tianqiQWQ/alpa-lens-board-generator/交付说明.md

# 交付说明 · ALPA 镜头板生成器 v4

## 交付物

| 文件 | 说明 |
|---|---|
| **`ALPA镜头板生成器.html`** | **主交付物**：单文件离线网页（726 KiB），双击即用；three.js 已内联，无任何外部请求 |
| `index.html` | GitHub Pages 入口（与主文件同内容） |
| `samples/` | 7 组预设的 STL / 3MF / 参数 TXT + `samples.json` 索引 |
| `preview/` | 12 张截图（方箱等轴/正视/剖视/俯视/仰视/80、⌀35 板、凸台、锥面板、锥形延长、移动端、非法参数） |
| `src/` `vendor/` | 源码（6 个模块）与内联依赖 |
| `tools/` | 打包、几何单测、端到端、静态验收、样例生成、参考件提取 |
| `README.md` | 使用说明 + 几何定义 + 与参考件对比 + 打印建议 |
| `LICENSE` | MIT |

## 本轮新增（v3.1 → v4）

**第二种延长方式：方箱延长**，按 `ALPA猪嘴 130mm延长.step` 复刻：

| 项 | 实测 / 规则 |
|---|---|
| 总长 | **130 = 底板 3 + 方桶 124 + 顶板 3**，可调 10–220 |
| 底板 | ALPA 板轮廓（78/82.5/88.5 × 3 mm），中间方孔 = 内腔 |
| 方桶 | 四面直壁，**外 88.5 方**，内腔 = 88.5 − 2×壁厚（壁厚默认 6.25 → 内 76） |
| 顶板 | 3 mm，中心开孔（圆孔 ⌀D 或内螺纹，默认 M65×1，贯通 3 mm） |
| 外观 | 88.5 方 + 阶梯切角（R3/R6），按参考件复刻 |
| 底板 | ALPA 板层级 78 R4 / 82.5 R5 / 88.5 R8 |
| 桶身 / 顶板 | 88.5 阶梯切角（连续切角） |
| 内壁 | 4 条光陷阱凹台（深 1.25 / 宽 46.7） |
| 体积 | 201,468 mm³（对齐 3MF 参考 201,949.9，−0.24 %） |

形态切换：「单板 / 锥形延长 / 方箱延长」三选一；方箱形态下「开口」卡片自动变成「顶面开口」，凸台卡片隐藏。

## 怎么用

1. 双击 `ALPA镜头板生成器.html`（Chrome / Edge）。
2. 左侧「形态」选 **方箱延长**：
   - 总长（默认 130）
   - 桶壁厚（默认 6.25，下方自动显示内腔尺寸与分段）
   - 「顶面开口」：圆孔 ⌀D 或 内螺纹（M65/M52/M42… 或自定义）
3. 选「单板」：板型 / 凸台 0–5 / 圆孔或内螺纹；选「锥形延长」：延长长度 / 外锥根部 / 顶端螺纹。
4. 右上：等轴 / 正视 / 侧视 / 俯视 / 仰视，可开剖视、标注、线框；`1–5` 是视图快捷键。
5. 底部导出 STL / 3MF / 参数 JSON / 参数 TXT / 截图。

## 验收摘要（本机实测）

| 检查 | 结果 |
|---|---|
| `tools/test-geometry.mjs` | **117 / 117** 通过 |
| `tools/verify-built.mjs` | **23 / 23** 通过 |
| `tools/e2e.mjs` | **85 / 85** 通过（含方箱几何、真实下载、剖视、三个形态切换、零报错） |
| 方箱 | 以 3MF 切面为准：外形、内腔、光陷阱凹台全部对上；体积 201,468 vs 201,950（−0.24 %） |

## 会拦截 / 提示的情况

| 情况 | 行为 |
|---|---|
| 方箱总长 < 10 或 > 220 | 红字拦截 |
| 方箱壁厚 < 2 或 > 20 | 红字拦截 |
| 方箱总长 < 8（底板 3 + 顶板 3 + 桶 2） | 红字拦截 |
| 顶面孔 / 螺纹 > ⌀82.5 | 红字拦截（按 88.5 顶板算） |
| 方箱 > 150 mm | 黄字提示注意刚性 |
| 锥形：外锥太钝 / 内锥超 ⌀77 / 壁厚 < 1.5 | 红字拦截 |
| 单板：凸台壁厚 < 1.2 / 锥面 > 60° | 红字拦截 / 黄字提示 |

## 本轮修正（v4.4）

1. **底板开口固定为 76**（+0.5 浅凹台，取自参考件），调壁厚时只有桶身内腔变化，底板不动。
2. **顶面孔上限改成 ⌀82.5**（顶板外形 88.5，留 3 mm 边），不再用内腔去限制；之前误限到 ⌀62.5–74。

## v4.5 默认值变更

- **默认延长高度全部改为 20 mm**：锥形延长 `extLen=20`（总高 23）；方箱延长 `boxLen=20`（底板 3 + 方桶 14 + 顶板 3）。参考件长度保留为预设（方箱 130、锥形 21.4）。
- 预设表扩到 7 个，`samples/` 随之变为 7 组。
- 三种形态各补一张全景 + 一张截面示例图（合计 14 张）。

## 后续可做

- 方箱的光陷阱台阶、8 条角部纵向孔
- 两件式延长桶（可换螺纹前板）
- 相机侧卡口槽、沉台 / Copal 沉孔
- 真 B-rep STEP 输出（build123d，复用同一套参数 JSON）供 CNC
