tianqiQWQ/alpa-lens-board-generator/samples/ALPA_方箱_M65x1_L20_W6.25mm.3mf

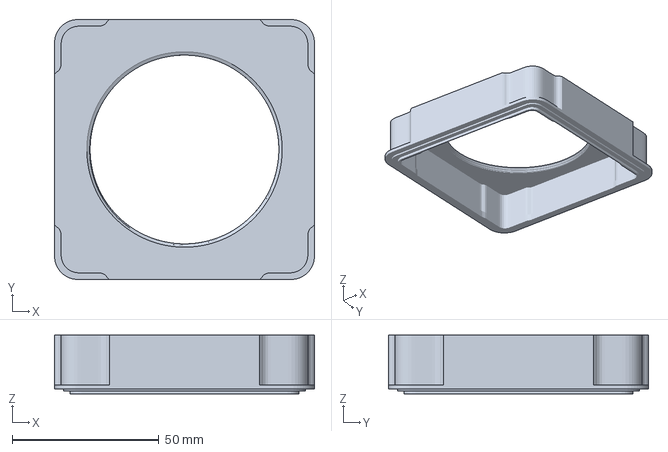
[picture p12: CAD file, 2026-11-07]
samples/ALPA_方箱_M65x1_L20_W6.25mm.3mf
88.5 x 88.5 x 20.0 mm
