tianqiQWQ/alpa-lens-board-generator/samples/ALPA_标准板_D35_H3mm.3mf

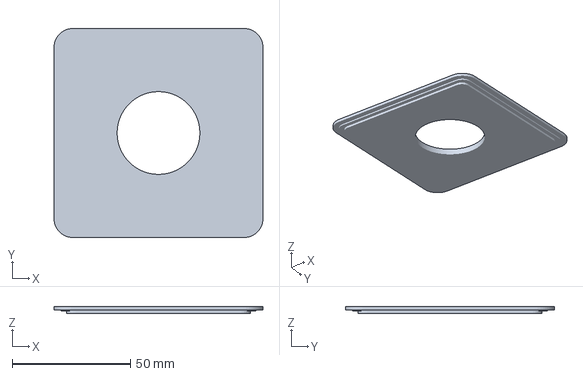
[picture p13: CAD file, 2026-11-07]
samples/ALPA_标准板_D35_H3mm.3mf
88.5 x 88.5 x 3.00 mm
