tianqiQWQ/alpa-lens-board-generator/samples/ALPA_锥面板_M65x1_boss2_H5mm.3mf

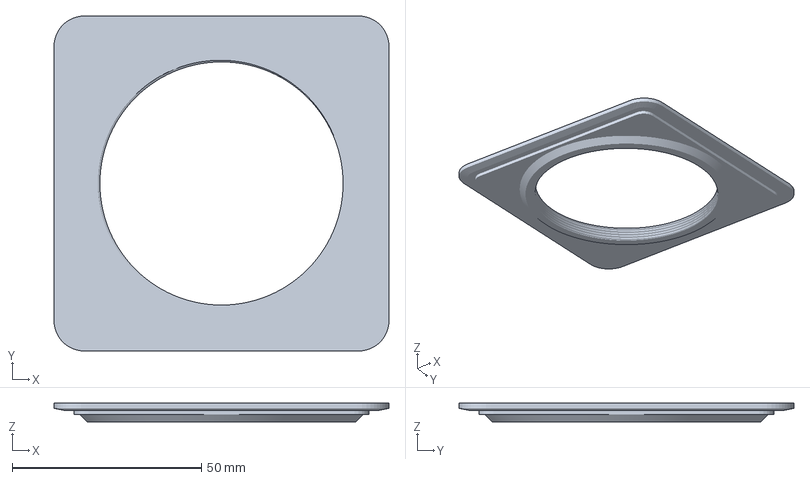
[picture p14: CAD file, 2026-11-07]
samples/ALPA_锥面板_M65x1_boss2_H5mm.3mf
88.5 x 88.5 x 5.00 mm
