tianqiQWQ/alpa-lens-board-generator/samples/ALPA_锥形延长_M42x1_L20_H23mm.3mf

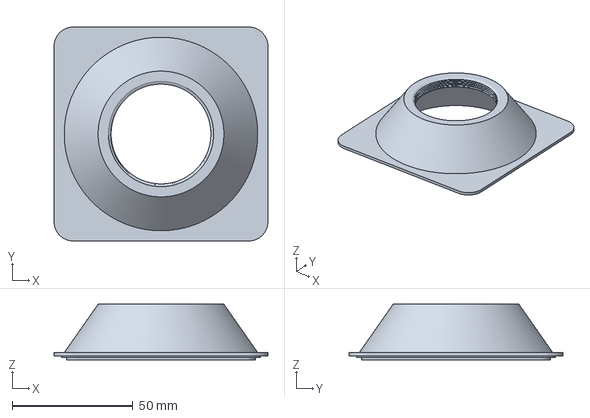
[picture p15: CAD file, 2026-11-07]
samples/ALPA_锥形延长_M42x1_L20_H23mm.3mf
88.5 x 88.5 x 23.0 mm
