tianqiQWQ/alpa-lens-board-generator/samples/ALPA_方箱_M65x1_L130_W6.25mm.3mf

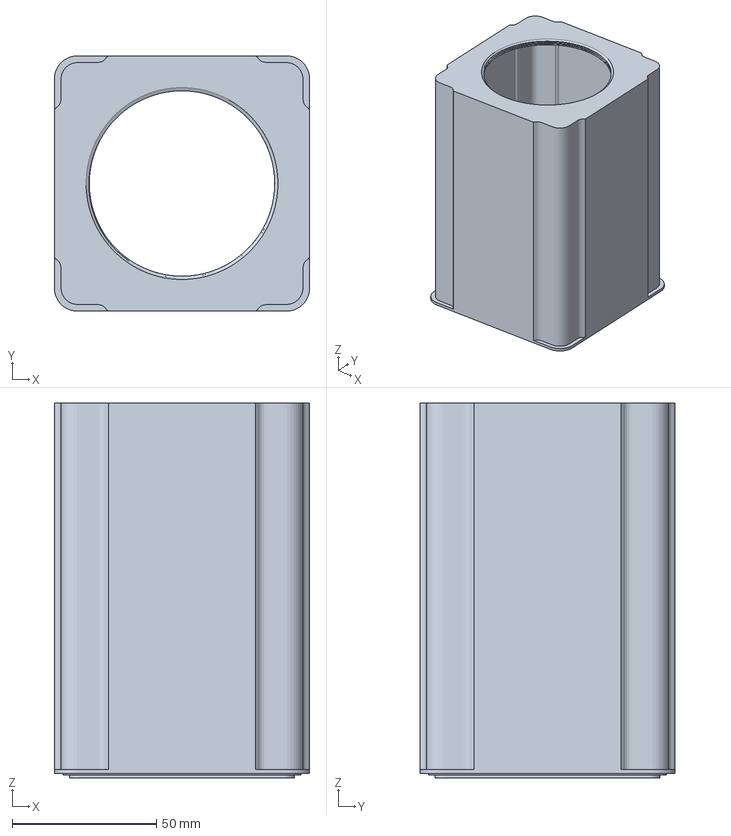
[picture p16: CAD file, 2026-11-07]
samples/ALPA_方箱_M65x1_L130_W6.25mm.3mf
88.5 x 88.5 x 130.0 mm
