tianqiQWQ/alpa-lens-board-generator/samples/ALPA_锥形延长_M42x1_L21.4_H24.4mm.3mf

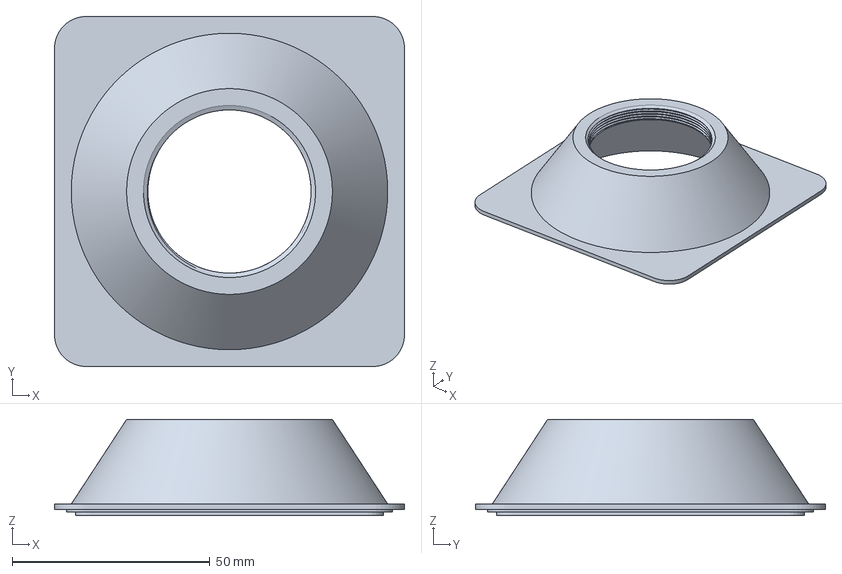
[picture p18: CAD file, 2026-11-07]
samples/ALPA_锥形延长_M42x1_L21.4_H24.4mm.3mf
88.5 x 88.5 x 24.4 mm
