tianqiQWQ/alpa-lens-board-generator/(list of files, cad)

Other CAD files:
samples/ALPA_方箱_D35_L20_W6.25mm.stl
samples/ALPA_方箱_M65x1_L130_W6.25mm.stl
samples/ALPA_方箱_M65x1_L20_W6.25mm.stl
samples/ALPA_标准板_D35_H3mm.stl
samples/ALPA_锥形延长_M42x1_L20_H23mm.stl
samples/ALPA_锥形延长_M42x1_L21.4_H24.4mm.stl
samples/ALPA_锥面板_M65x1_boss2_H5mm.stl
