tianqiQWQ/alpa-lens-board-generator/(commit log)

2026-11-07 feat: ALPA 镜头板生成器 v4 —— 单板 / 锥形延长 / 方箱延长参数化生成器
    单文件离线网页工具：参数化生成 ALPA 大画幅镜头板、锥形延长桶、方箱延长桶（猪嘴），实时 three.js 预览，导出 STL / 3MF。
    - 三种形态：单板（自适应凸台 0–5 mm + 13 种内螺纹）、锥形延长（等壁厚自适应）、方箱延长（按 3MF 切面实测复刻）
    - 默认延长高度 20 mm，参考件长度（方箱 130 / 锥形 21.4）保留为预设
    - 验收：几何单测 122/122、成品静态验收 23/23、headless Chrome 端到端 85/85
    - 与参考件体积对齐：方箱 -0.24%、单板 -0.009%、锥面板 +0.04%
    [ALPA_方箱_D35_L20_W6.25mm.3mf, ALPA_方箱_D35_L20_W6.25mm.stl, ALPA_方箱_M65x1_L130_W6.25mm.3mf, ALPA_方箱_M65x1_L130_W6.25mm.stl, ALPA_方箱_M65x1_L20_W6.25mm.3mf, ALPA_方箱_M65x1_L20_W6.25mm.stl, ALPA_标准板_D35_H3mm.3mf, ALPA_标准板_D35_H3mm.stl]
2026-11-07 docs: 增加在线试用链接（GitHub Pages）与 demo 徽章
2026-11-07 docs: 增加 Release 徽章与 Releases 下载说明
2026-11-07 feat(figures): 三种形态各生成一张「全景 + 剖面 + 文字讲解」拼版示例图（纯 3D、无 UI）
    - 新增 tools/make-figures.mjs：headless Chrome 抓纯 canvas 画面（等轴 + 剖切）
    - 新增 tools/make-figures.py：Pillow 排版合成 2200x1240 示例图，含标题/说明/图注/要点
    - preview/fig-board.png、fig-cone.png、fig-box.png；README 三形态章节改用拼版图
    - 移除 README 不再引用的 6 张旧单图
2026-11-07 fix(figures): 直径符号改用 Ø（微软雅黑缺 ⌀ 字形，之前渲染成方框）
    同时给 tools/make-figures.py 增加 --no-notes / --out 参数，便于生成无讲解版。
